MouseBiteLabs/Game-Boy-Enhance/AGBM-11 (Lithium-ion)/schematic.pdf

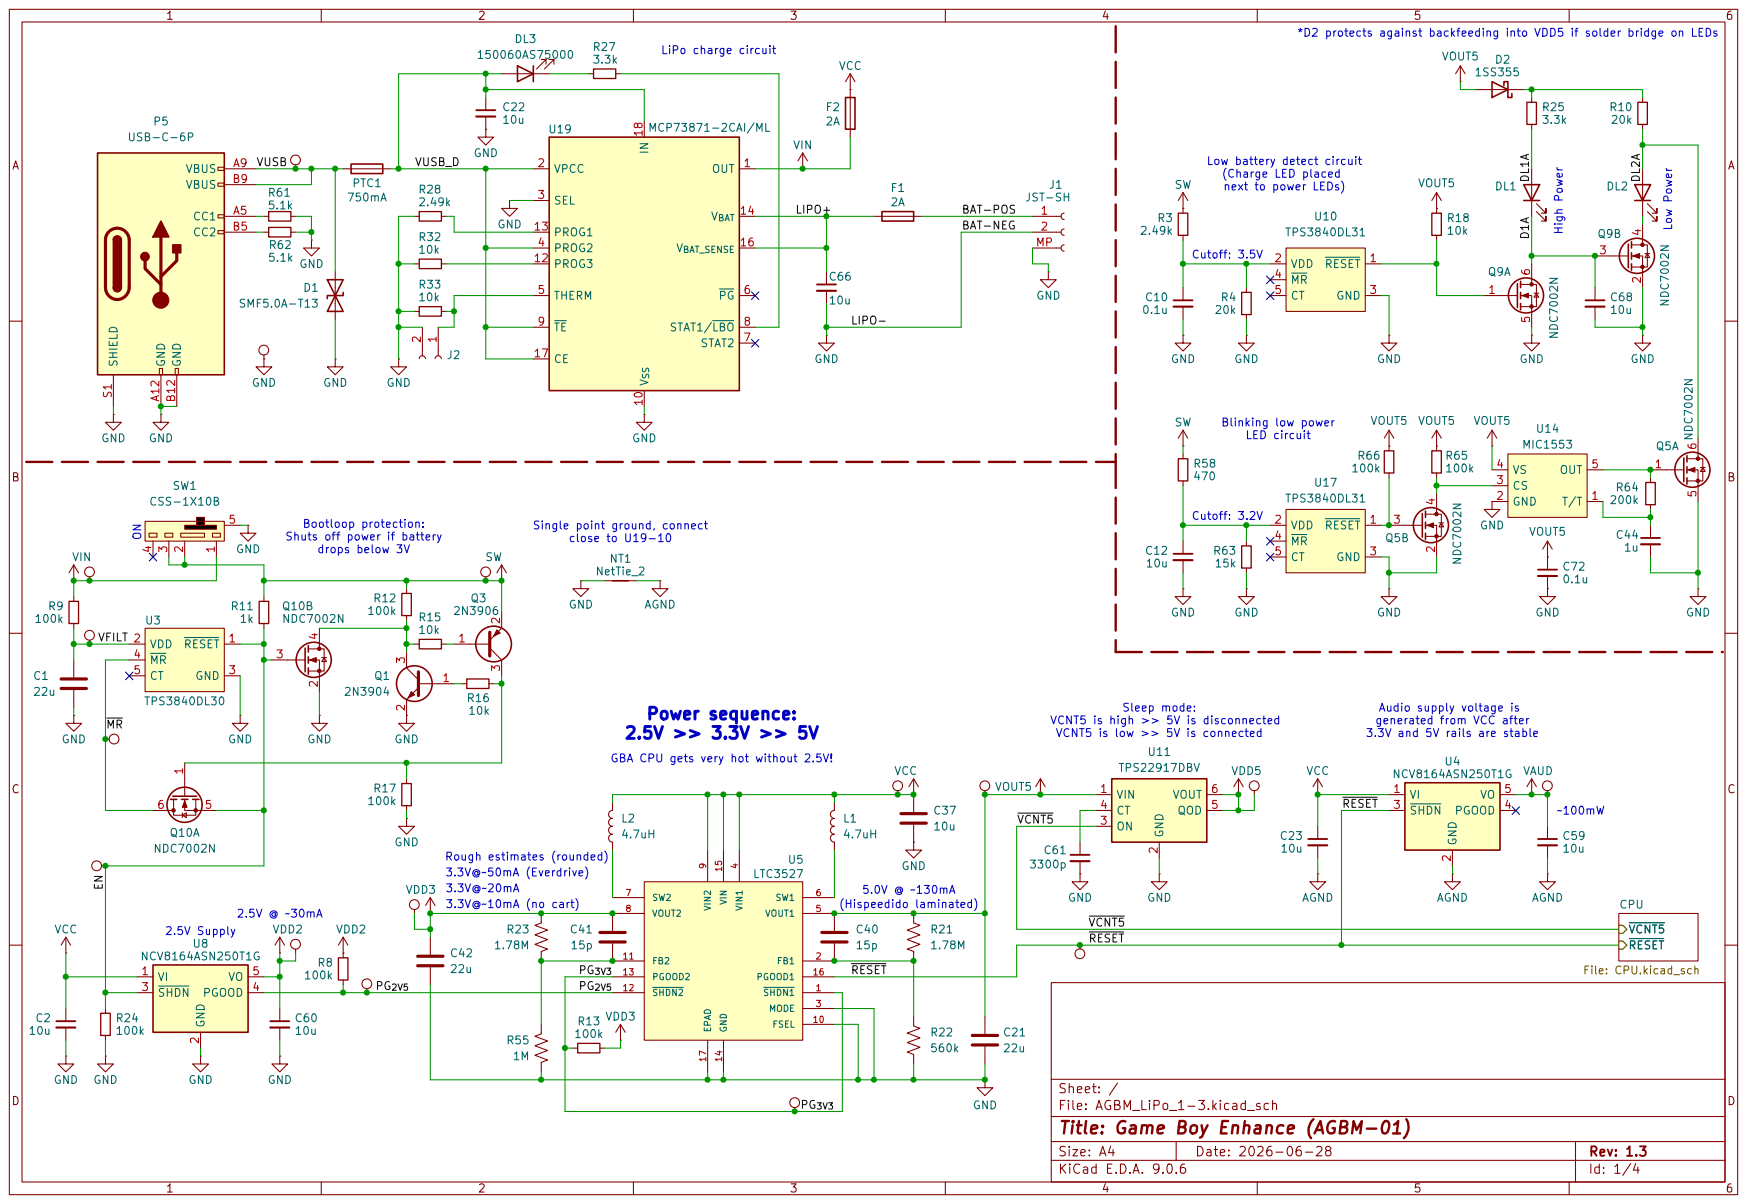
[picture p5: page 1]

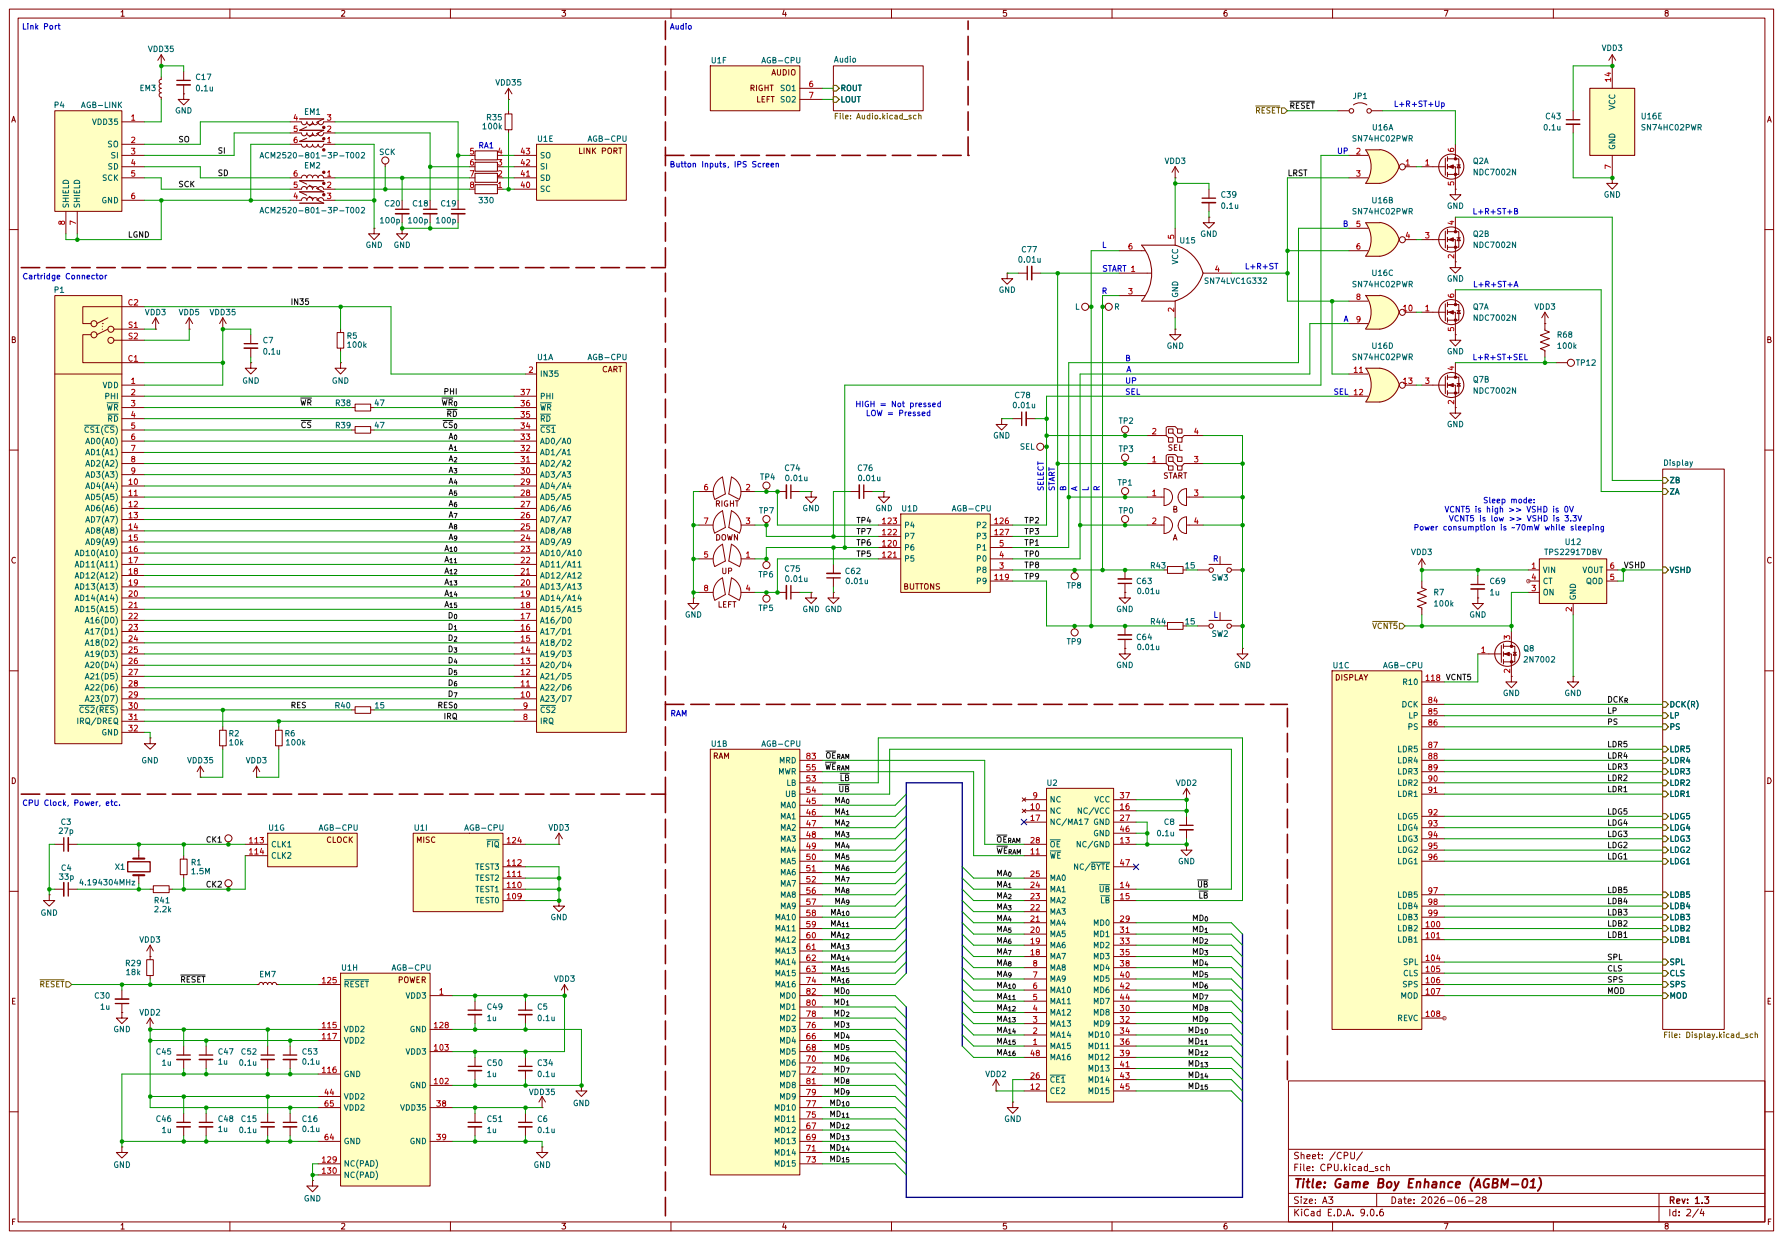
[picture p6: page 2]

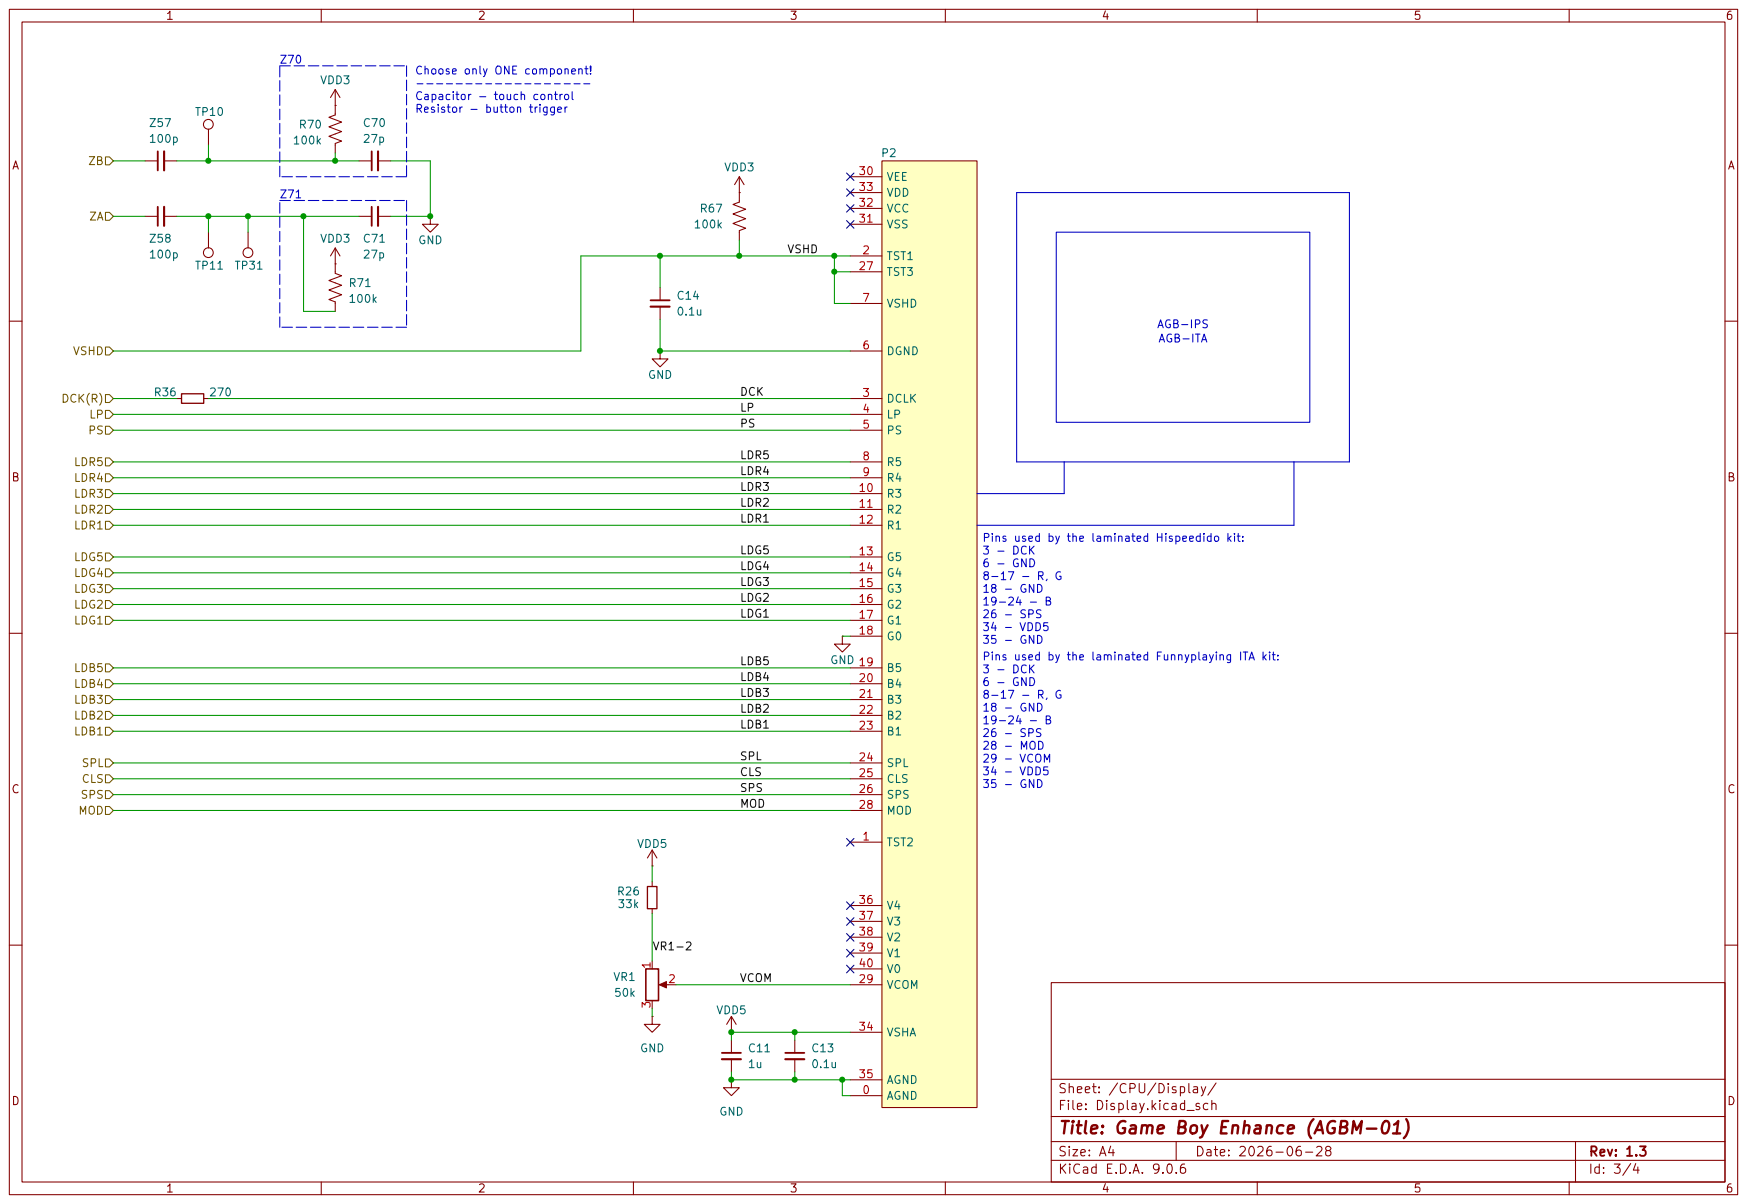
[picture p7: page 3]

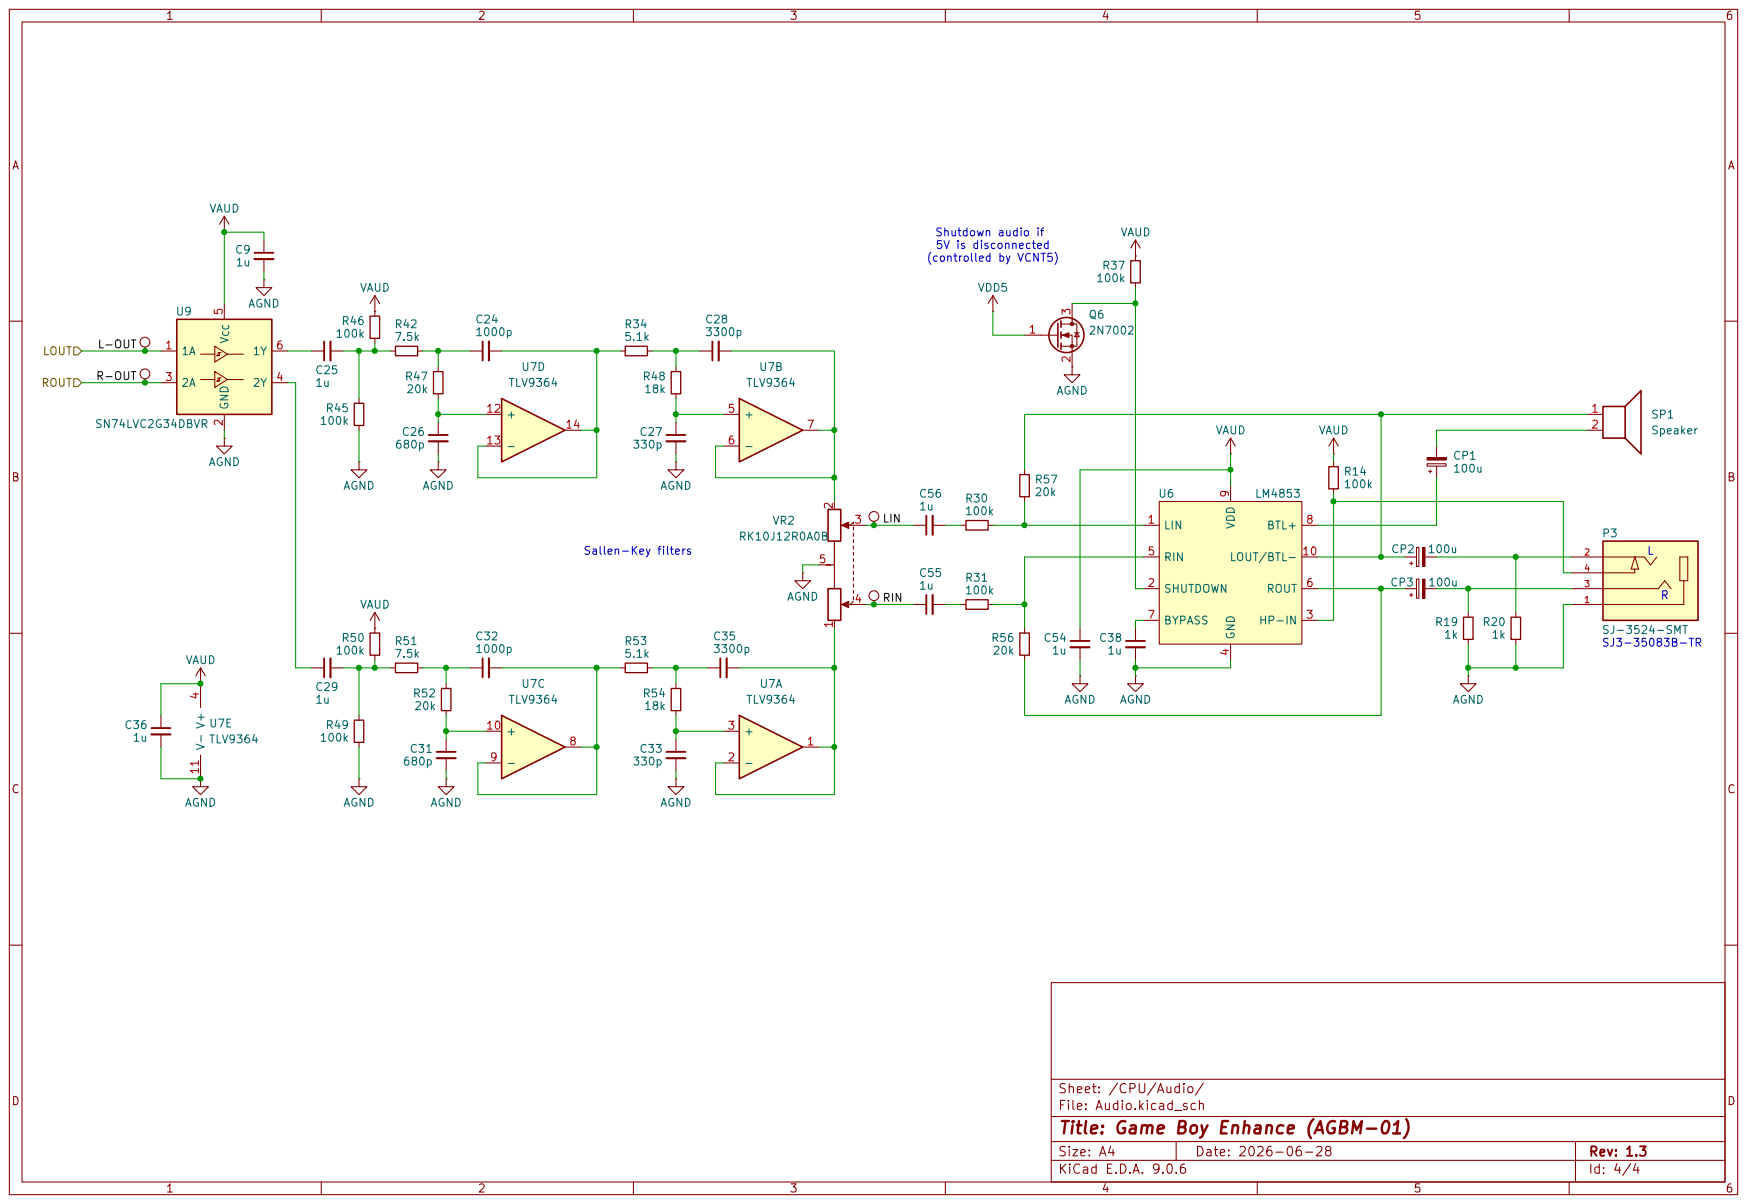
[picture p8: page 4]
