MouseBiteLabs/Game-Boy-Enhance/AGBM-01 (AA Batteries)/schematic.pdf

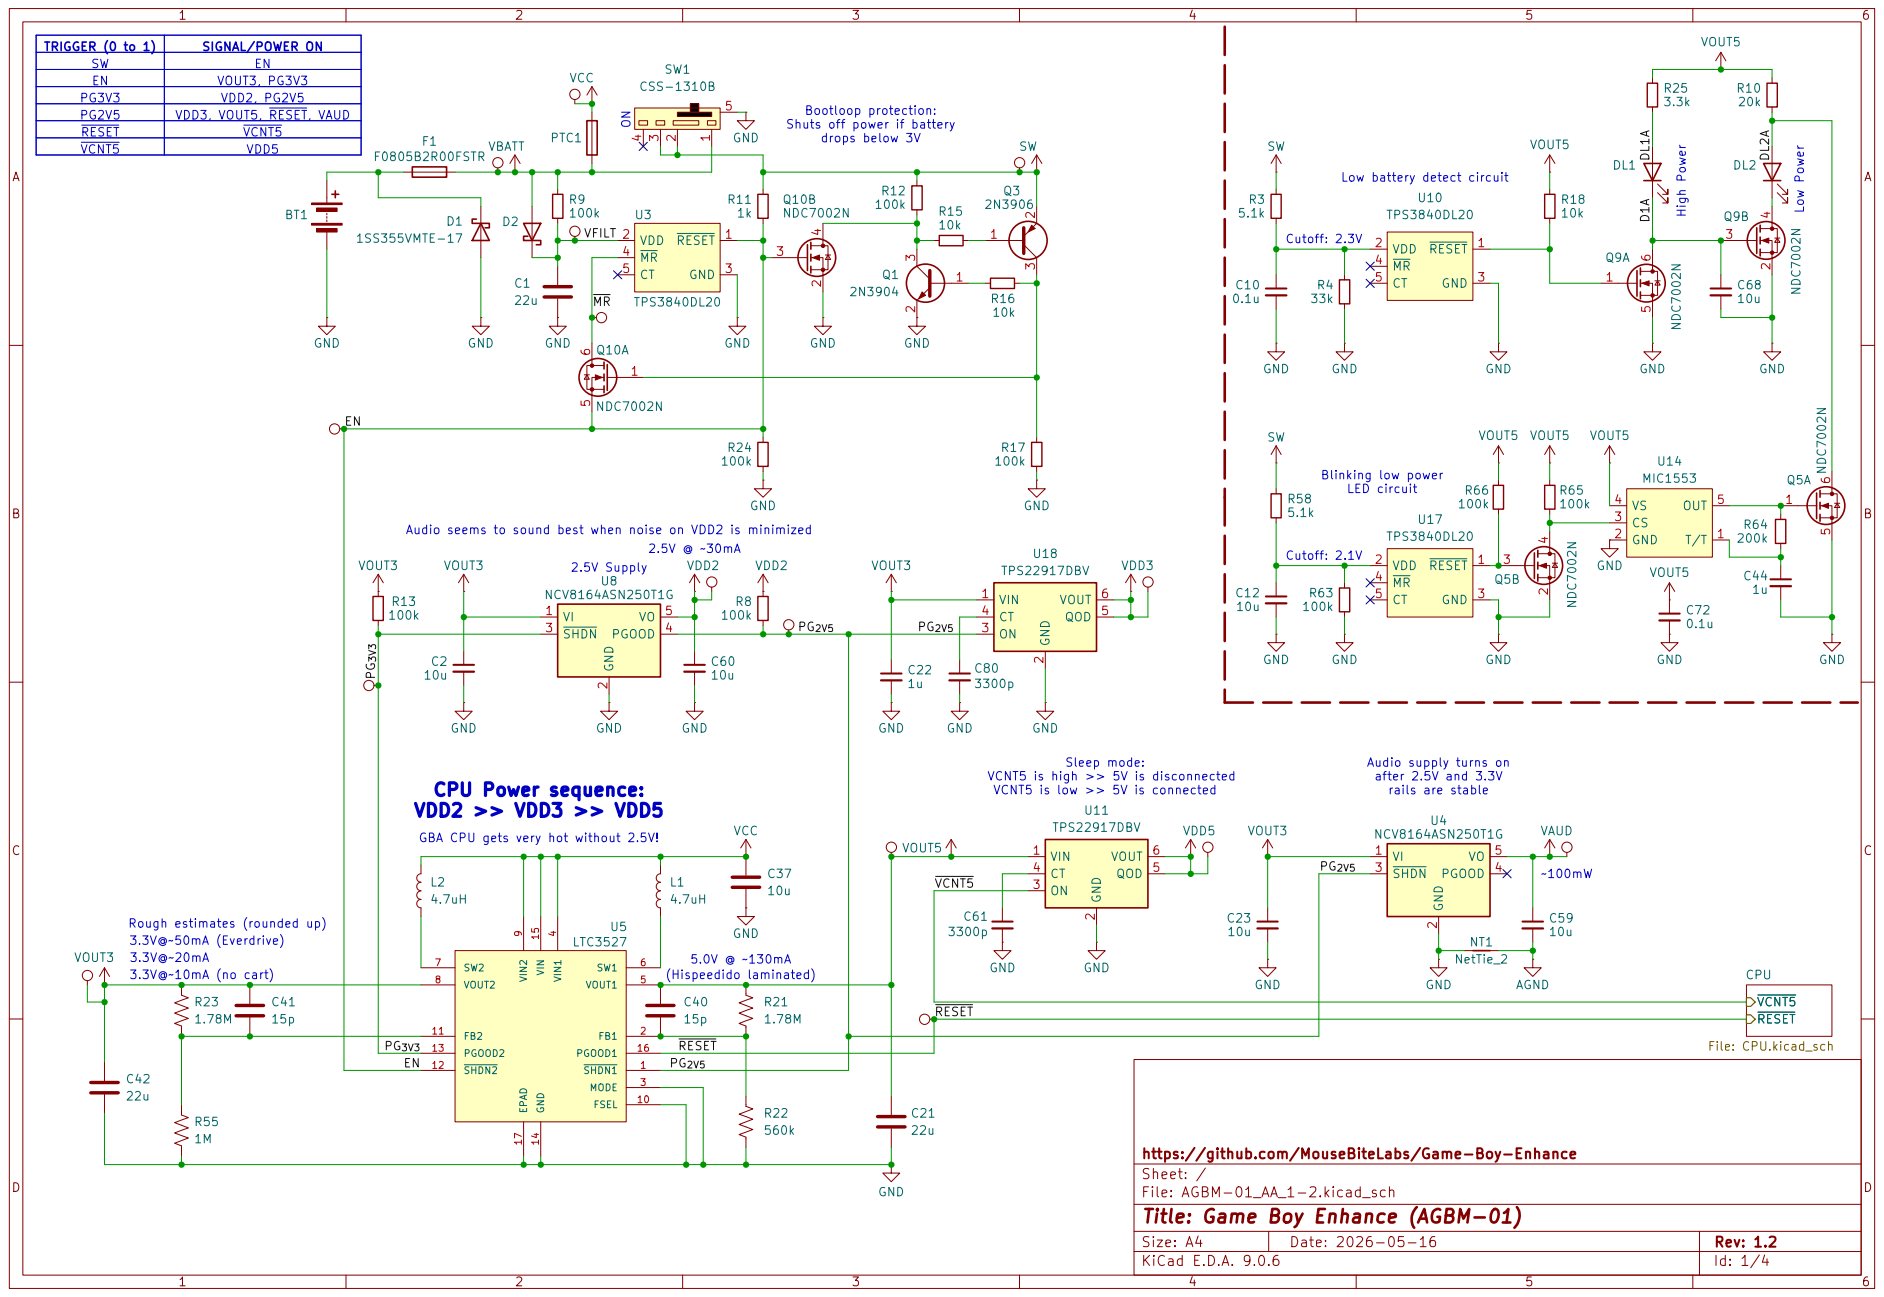
[picture p9: page 1]

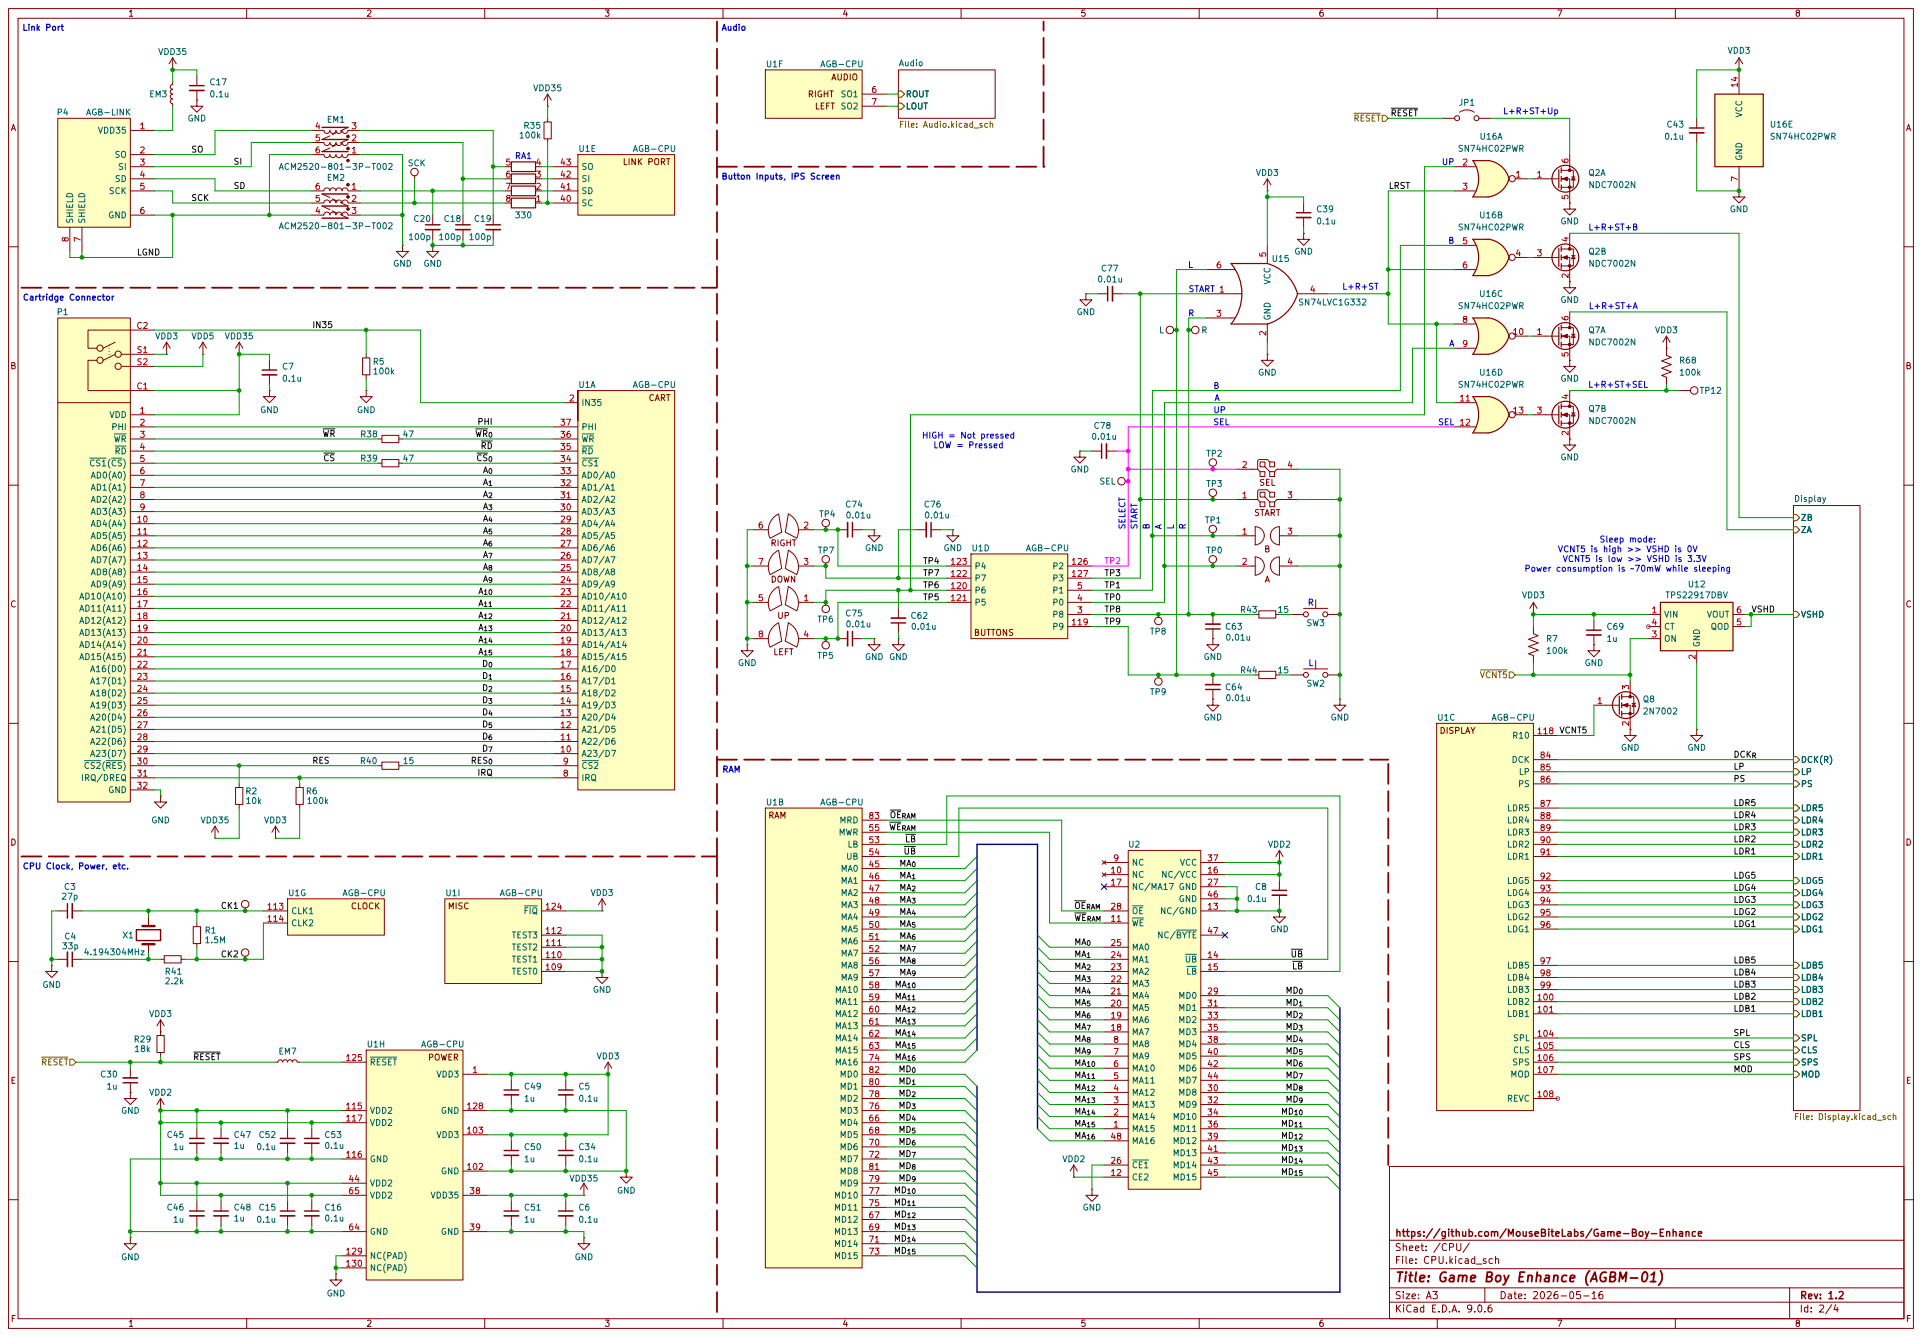
[picture p10: page 2]

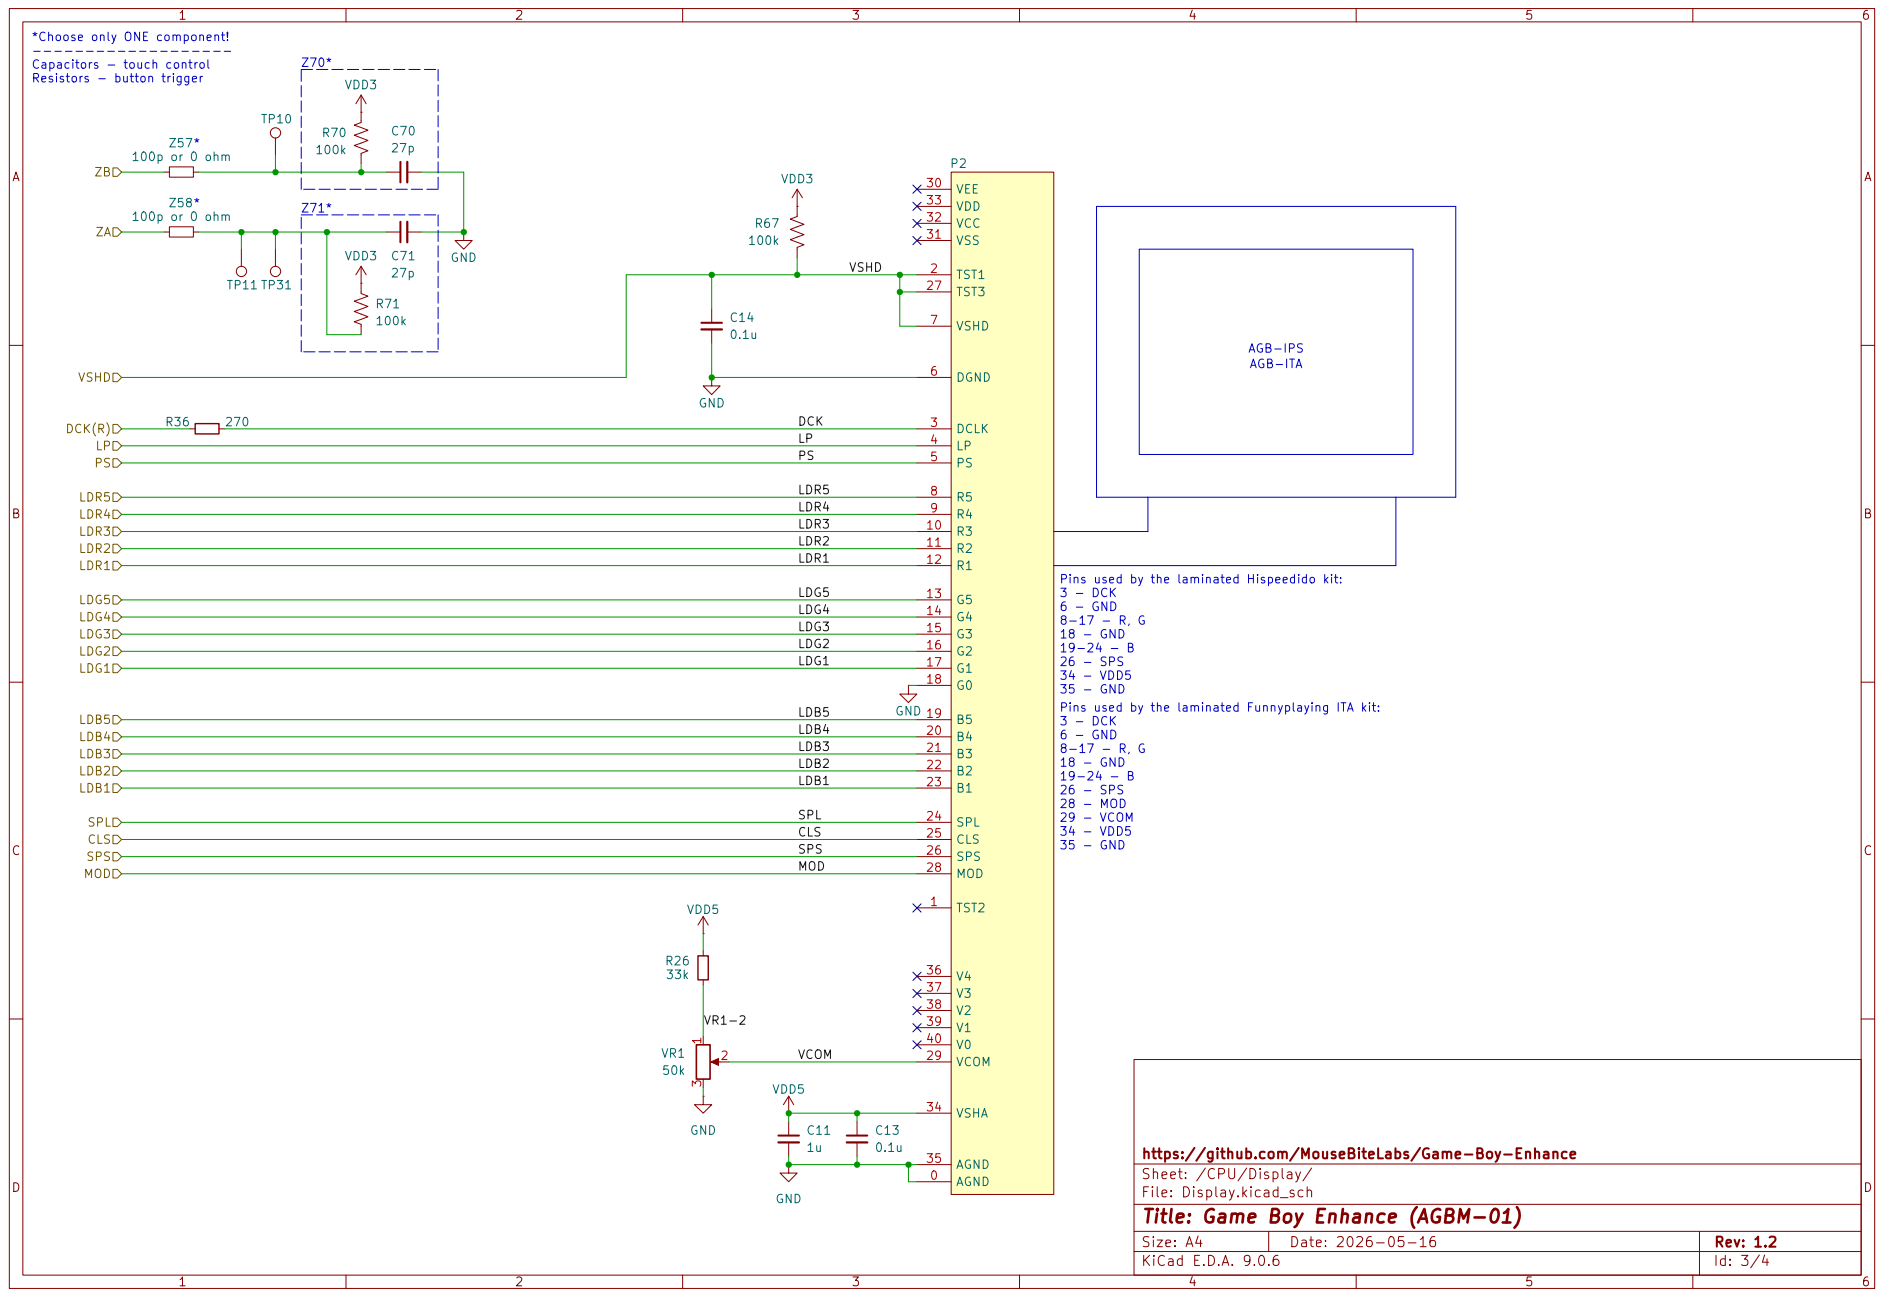
[picture p11: page 3]

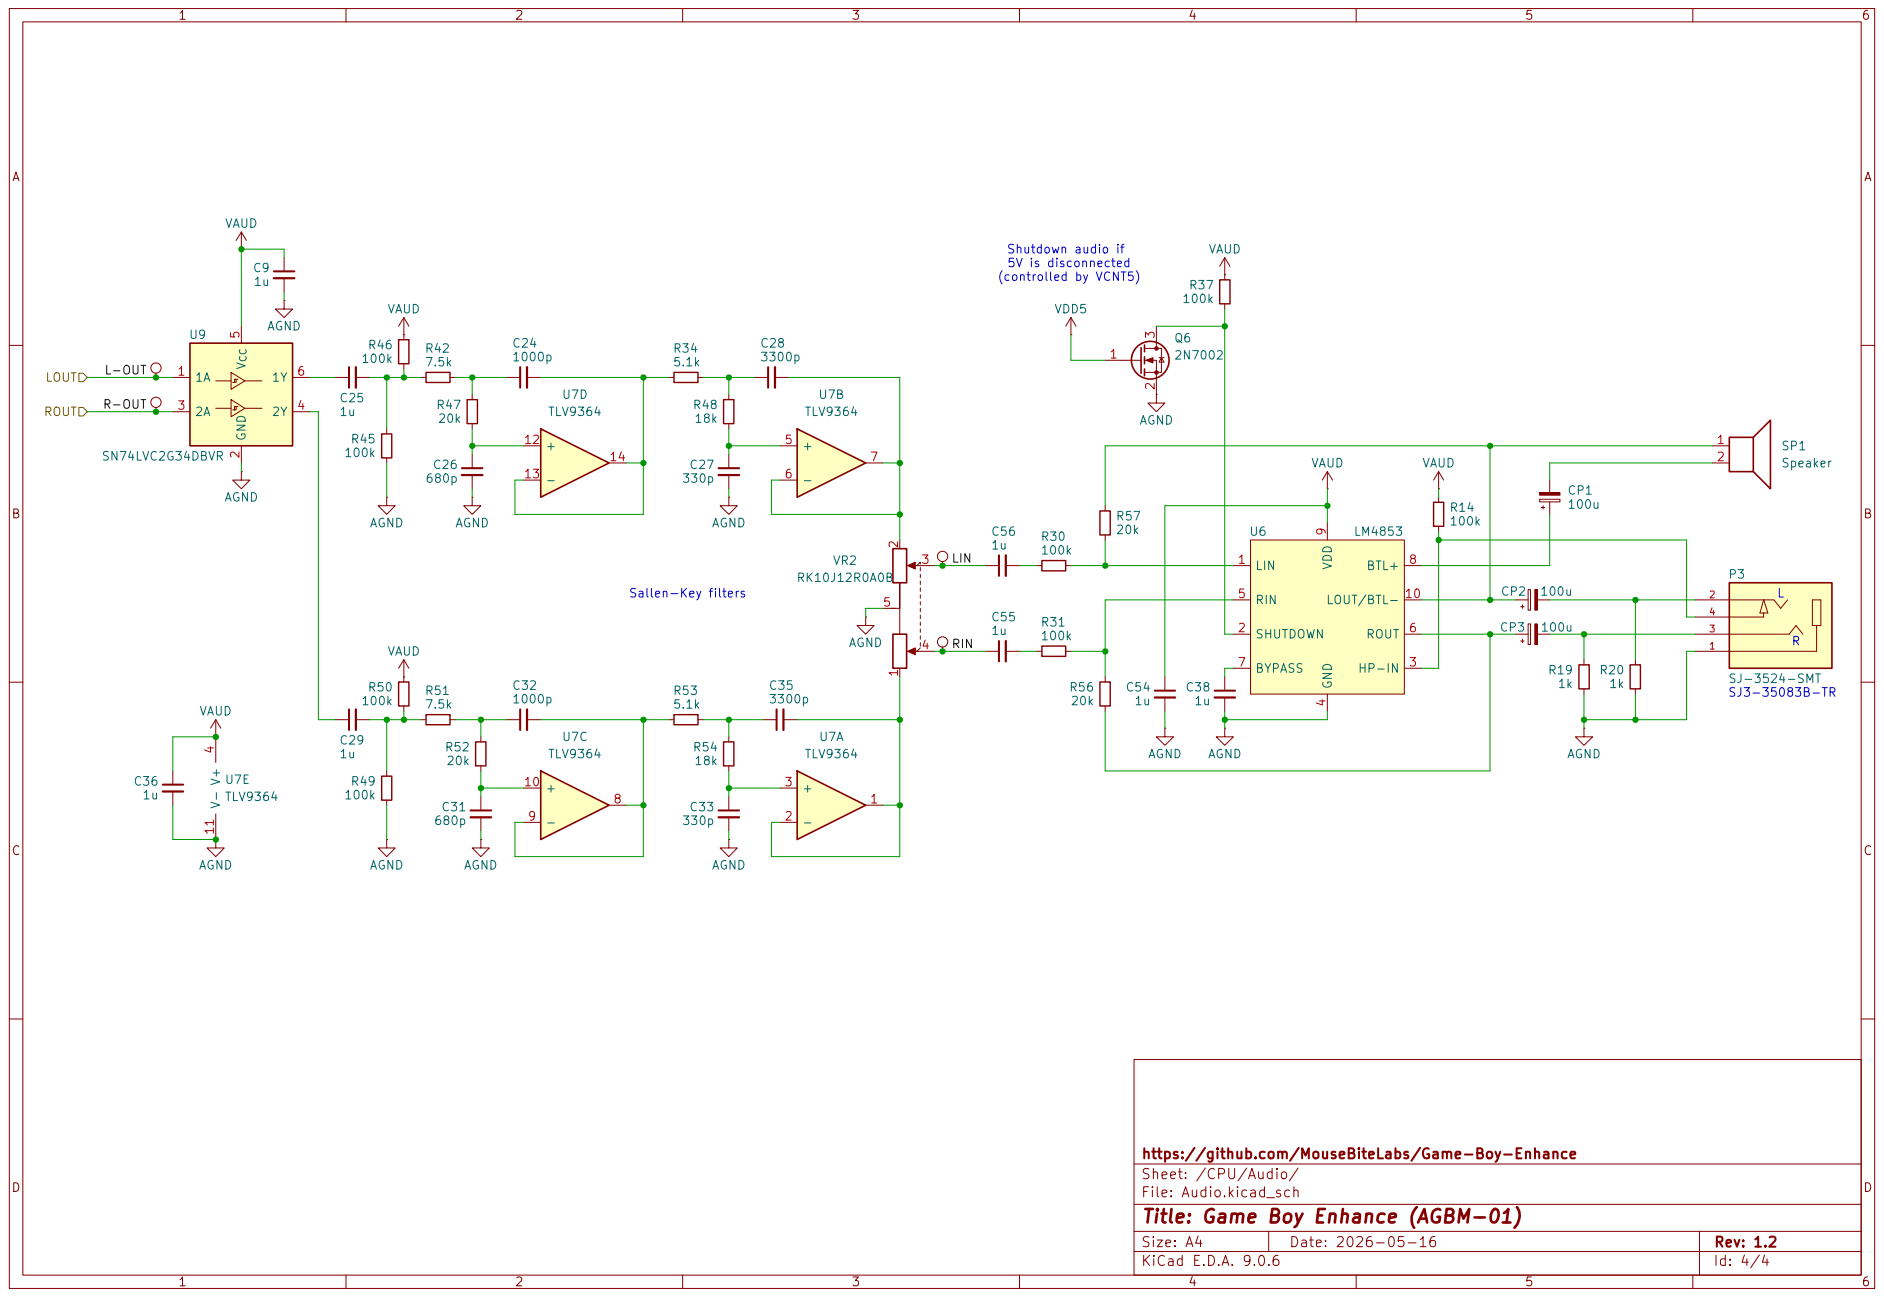
[picture p12: page 4]
