MouseBiteLabs/Game-Boy-Enhance/(commit log)

2026-03-31 THESE ARE NOT TESTED
    [AGBM_AA_1-0.kicad_sch, Audio.kicad_sch, CPU.kicad_sch, IPS.kicad_sch]
2026-08-19 Added .gitignore to make working with kicad and git easier
